Thuvarakaa/RIPPLE/README.md

# What is RIPPLE?
RIPPLE is a robotic system that is designed to collect small floating trash on the surface of local ponds. It will be remotely controlled by the user and communicate its location back to a User Interface (UI). A camera stream will also be displayed on the UI to allow the user to identify obstacles in the system’s path.\
**Team:** The Blue Guardians\
**Team Members:** Vedashri Pandya, Kaelyn Bamford, Avery Zeiler, Thuvarakaa Sathiyamether, Clara Yaromich, Shayda Rahmatyan\
**Advisor:** Alan Wassyng

# Repository Structure
> [!NOTE]
> The most recent update to this repository (July 3rd, 2026) is meant to provide a comprehensive image of the team's documentation. During project development stages, the team utilized Microsoft Teams to create and develop documentation for this project. **No code has been updated within this repository since the McMaster Engineering Capstone EXPO in April 2026.**

**archive:** code artifacts from previous stages of development (rev 0).\
**rev-1:** codebase in use on the RIPPLE system.\
**project-documentation:** contains all relevant submitted project documentation. *For information on the physical build of the RIPPLE system, including the mechanical and electrical design, refer to this folder.*

# Capstone Video Presentation
For an overview of RIPPLE, please find our Capstone video presentation [here](https://www.macvideo.ca/media/RIPPLE+-+TRON/1_2p7x8xuk).
