Thuvarakaa/RIPPLE/project-documentation/Group 14 - Capstone EXPO Poster.pdf

# UI Visualization

# Robotic Intervention for Pollution & Plastic Litter Extraction (RIPPLE)

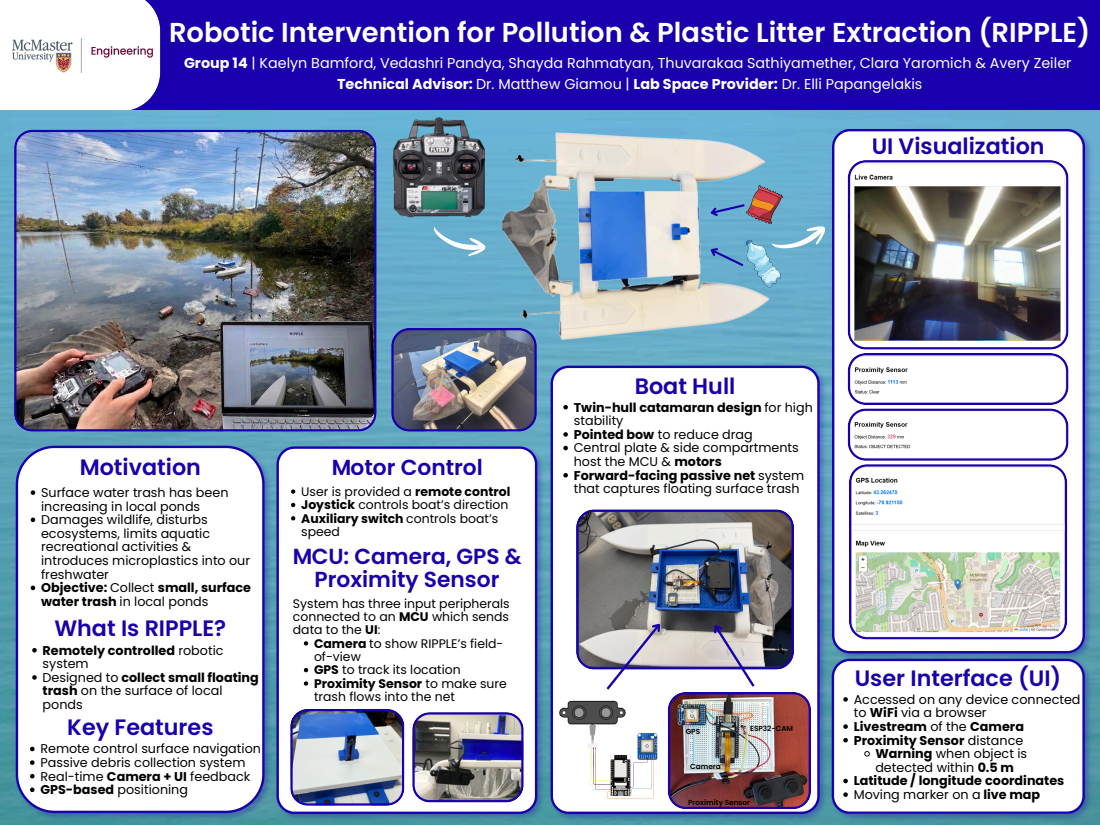
[picture p43: page 1]
Boat Hull; Proximity Sensor; GPS; ESP32-CAM; Camera

Group 14 | Kaelyn Bamford, Vedashri Pandya, Shayda Rahmatyan, Thuvarakaa Sathiyamether, Clara Yaromich & Avery Zeiler

Technical Advisor: Dr. Matthew Giamou | Lab Space Provider: Dr. Elli Papangelakis

Twin-hull catamaran design for high
stability
Pointed bow to reduce drag
Central plate & side compartments
host the MCU & motors
Forward-facing passive net system
that captures floating surface trash

Motivation
Surface water trash has been
increasing in local ponds
Damages wildlife, disturbs
ecosystems, limits aquatic
recreational activities &
introduces microplastics into our
freshwater
Objective: Collect small, surface
water trash in local ponds
What Is RIPPLE?
Remotely controlled robotic
system
Designed to collect small floating
trash on the surface of local
ponds
Key Features
Remote control surface navigation
Passive debris collection system
Real-time Camera + UI feedback
GPS-based positioning

Motor Control
User is provided a remote control
Joystick controls boat’s direction
Auxiliary switch controls boat’s
speed
MCU: Camera, GPS &
Proximity Sensor
System has three input peripherals
connected to an MCU which sends
data to the UI:
Camera to show RIPPLE’s field-
of-view
GPS to track its location
Proximity Sensor to make sure
trash flows into the net

User Interface (UI)
Accessed on any device connected
to WiFi via a browser
Livestream of the Camera
Proximity Sensor distance
Warning when object is
detected within 0.5 m
Latitude / longitude coordinates
Moving marker on a live map
