Thuvarakaa/RIPPLE/gps_test.py

import time
from machine import UART, Pin
import sys

Pin(13, Pin.IN)
Pin(14, Pin.OUT)

uart1 = UART(1, baudrate=9600, bits=8, parity=None, rx=13, tx=14, stop=1)
uart1.init()
print('Successfully initialized')
for runs in range(0, 10):
    delay_gps = 0
    collect_flag = False
    for i in range(0, 400):
        present = uart1.any()
        if present != 0:
            collect_flag = True
            break
        time.sleep(1)
        delay_gps += 1
        if (delay_gps % 20) == 0:
            print('Still waiting...')
    if collect_flag == False:
        print('Unable to collect data.')
        sys.exit()
    else:
        print(f'Time to get data round {runs+1}: {delay_gps}s')
        buf = uart1.readline().decode('utf-8')
        print(buf)
        
        
        

#time.sleep(0)
#one_line = uart1.read()
#print(type(one_line))
#print(one_line)
