Thuvarakaa/RIPPLE/(commit log)

2026-01-19 Add files via upload
    Camera module
2026-01-19 Update picoweb_video.py
    updated UI: took out flash and refresh and flipped camera
    [picoweb_video.py]
2026-01-20 modularized code for camera and UI
    modularized code
2026-01-20 UART gps code
    Kaelyn's UART code
